julianschick/pragotron-clock/pcb/pragotron-clock.kicad_pcb

## KiCad design pcb/pragotron-clock.kicad_pcb (2026-09-22)

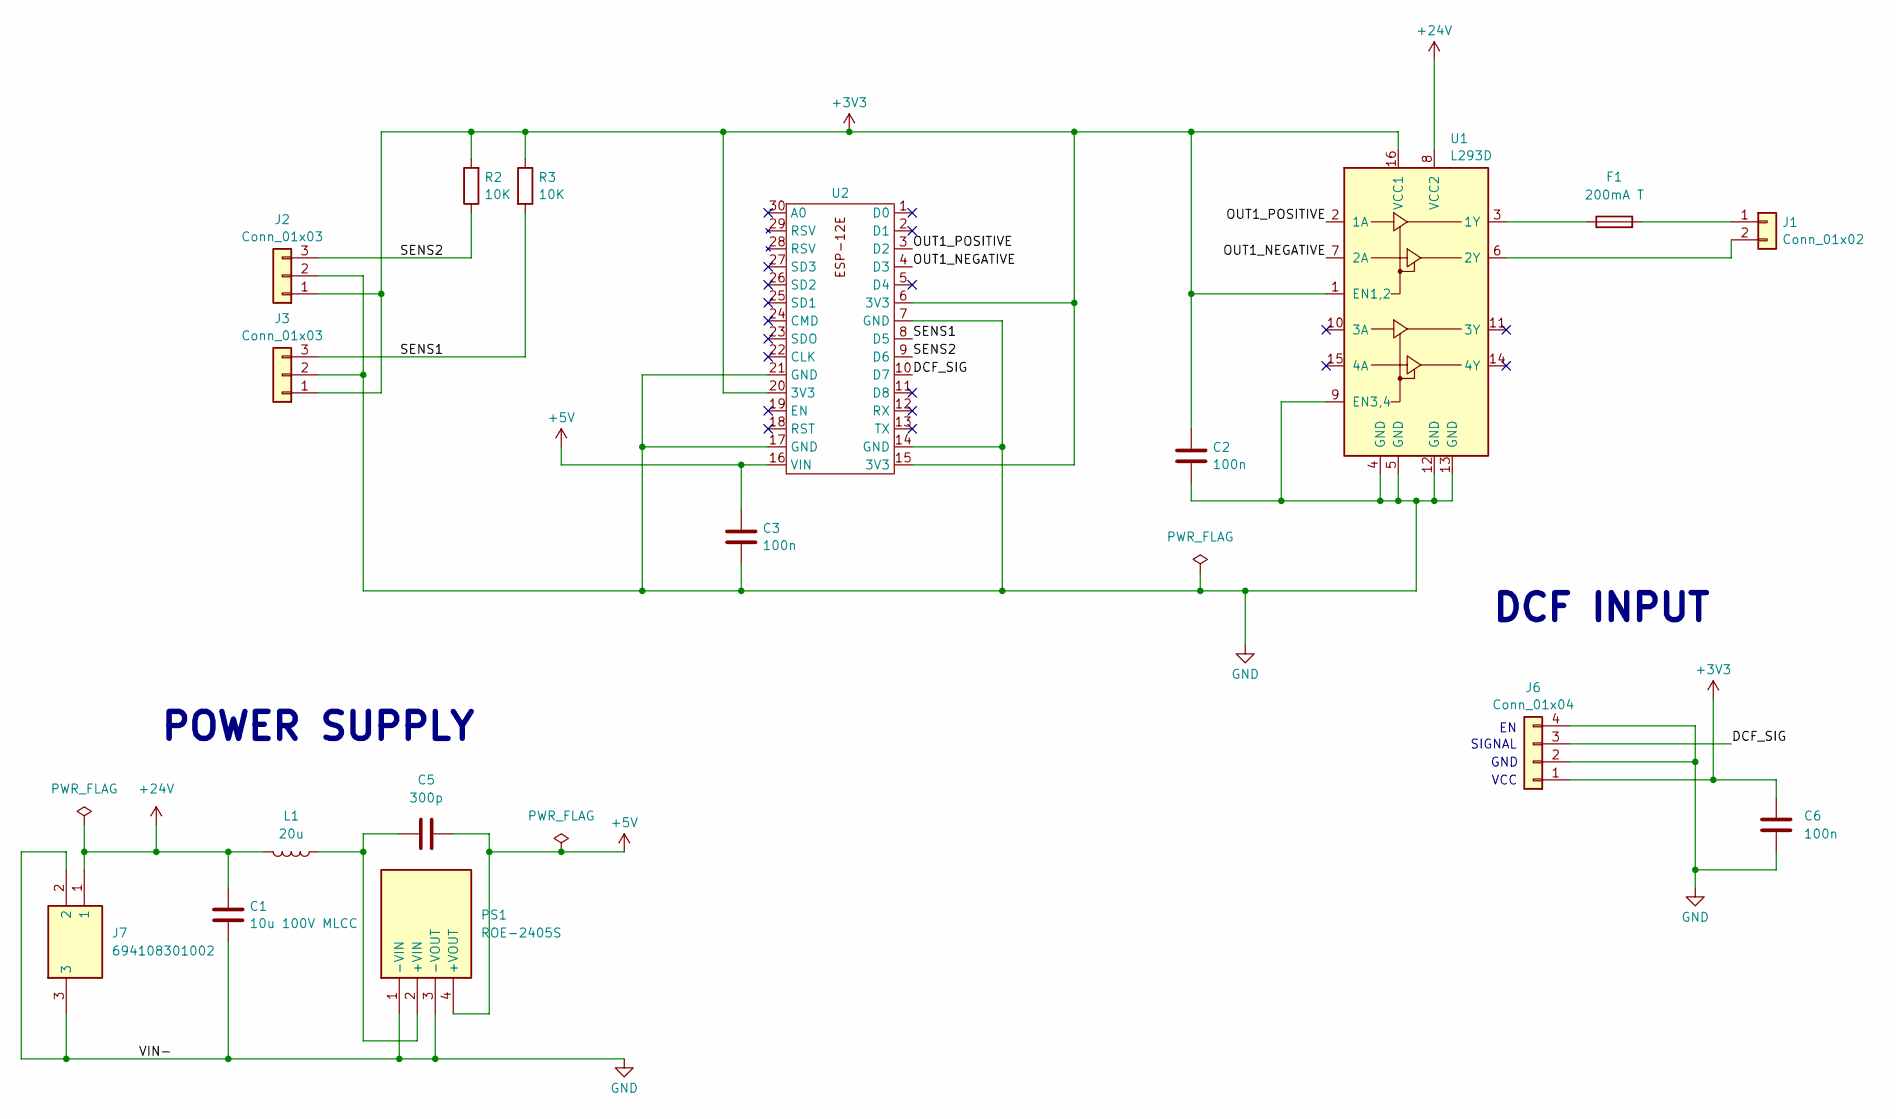
[picture p1: schematic pragotron-clock.kicad_sch]

Parts:
C1: 10u 100V MLCC; C_Rect_L7.0mm_W3.5mm_P5.00mm
C2, C3, C6: 100n; C_1206_3216Metric_Pad1.33x1.80mm_HandSolder
C5: 300p; C_1206_3216Metric_Pad1.33x1.80mm_HandSolder
F1: 200mA T; Fuse_1206_3216Metric_Pad1.42x1.75mm_HandSolder
J1: Conn_01x02; JST_XH_S2B-XH-A-1_1x02_P2.50mm_Horizontal
J2, J3: Conn_01x03; JST_XH_S3B-XH-A-1_1x03_P2.50mm_Horizontal
J6: Conn_01x04; DCF77
J7: 694108301002; Mouser Part Number 710-694108301002
L1: 20u; RLS226
PS1: ROE-2405S; ROE1205S; Mouser Part Number 919-ROE-2405S
R2, R3: 10K; R_1206_3216Metric_Pad1.30x1.75mm_HandSolder
U1: L293D; DIP-16_W7.62mm
U2: ESP8266_12E_DEVKIT

Connections:
+3V3: C2.1, C6.1, J2.1, J3.1, J6.1, R2.2, R3.1, U1.1 (EN1,2), U1.16 (VCC1), U2.6 (3V3), U2.15 (3V3), U2.20 (3V3)
+5V: C3.1, C5.1, PS1.4 (+VOUT), U2.16 (VIN)
+24V: C1.1, J7.1, L1.2, U1.8 (VCC2)
/DCF_SIG: J6.3, U2.10 (D7)
/OUT1_NEGATIVE: U1.7 (2A), U2.4 (D3)
/OUT1_POSITIVE: U1.2 (1A), U2.3 (D2)
/SENS1: J3.3, R3.2, U2.8 (D5)
/SENS2: J2.3, R2.1, U2.9 (D6)
GND: C1.2, C2.2, C3.2, C6.2, J2.2, J3.2, J6.2, J6.4, J7.2, J7.3, PS1.1 (-VIN), PS1.3 (-VOUT), U1.4 (GND), U1.5 (GND), U1.9 (EN3,4), U1.12 (GND), U1.13 (GND), U2.7 (GND), U2.14 (GND), U2.17 (GND), U2.21 (GND)
unnamed: F1.2, J1.1
unnamed: J1.2, U1.6 (2Y)
unnamed: C5.2, L1.1, PS1.2 (+VIN)
unnamed: F1.1, U1.3 (1Y)

Notes on the sheet:
GND
DCF INPUT
SIGNAL
POWER SUPPLY
VCC

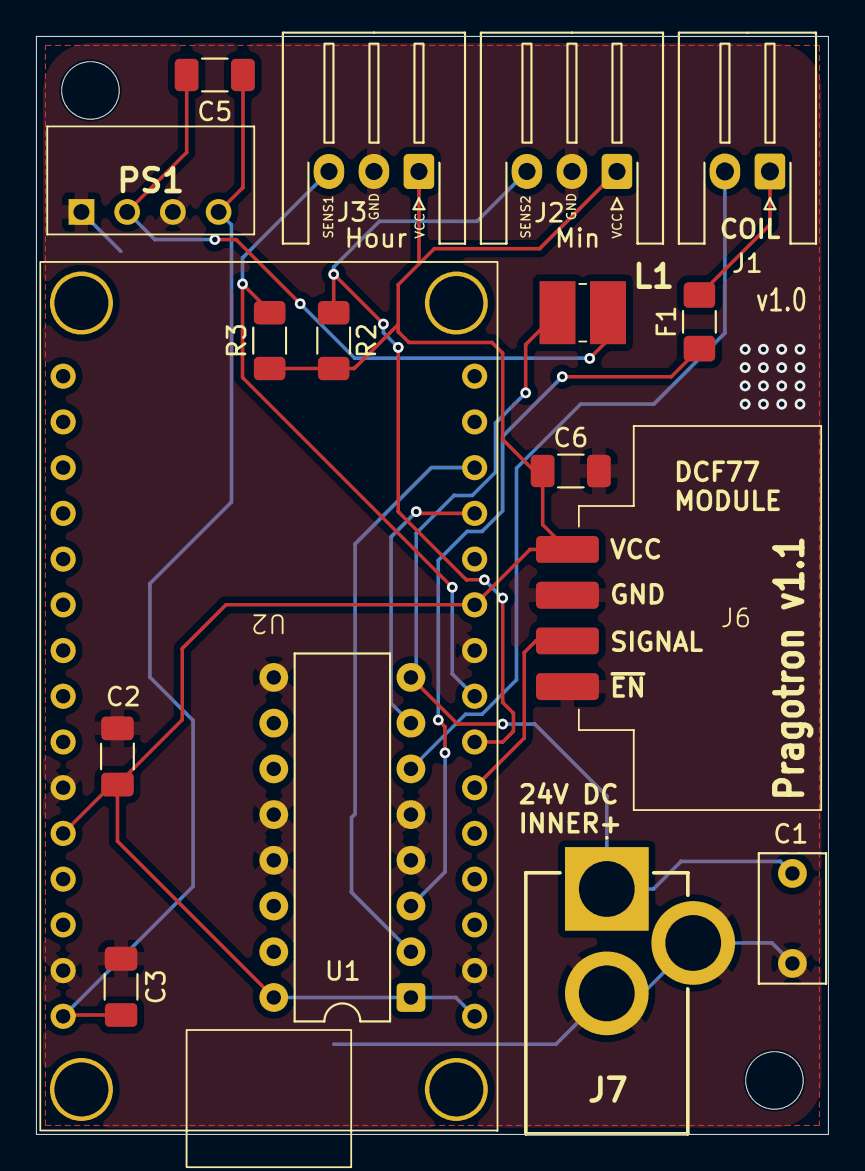
[picture p2: board pragotron-clock.kicad_pcb from above]

Board: 2 copper layers, 44.0 x 61.0 mm, 17 parts (0 on the bottom side), 13 nets.
