julianschick/pragotron-clock/(commit log)

2026-02-22 control schematic
    [pragotron-clock.kicad_pcb, pragotron-clock.kicad_sch]
2026-02-28 add firmware
    [pragotron-clock.kicad_pcb, pragotron-clock.kicad_sch]
2026-03-21 wip firmware and schematics
    [pragotron-clock.kicad_sch]
2026-03-25 schematics finished
    [pragotron-clock.kicad_pcb, pragotron-clock.kicad_sch]
2026-03-31 gerber v1.0
    [pragotron-clock.kicad_pcb, pragotron-clock.kicad_sch]
2026-04-01 fuse specification
    [pragotron-clock.kicad_sch]
2026-09-22 remove ground separation, turn around esp8266
    [pragotron-clock.kicad_pcb, pragotron-clock.kicad_sch]
2026-09-29 firmware_ntp: "uncommit" fixed shift
    [clock.h]
2026-09-30 firmware_ntp: led magic
